generationmake/CyphalHMIBase-CAN/README.md

# CyphalHMIBase-CAN
HMI Board for the Raspberry Pi Pico with a display and some knobs to connect via CAN using OpenCyphal and UCANPHY Micro
