generationmake/CyphalHMIBase-CAN/kicad_source/CyphalHMIBase-CAN.kicad_pcb

## KiCad design kicad_source/CyphalHMIBase-CAN.kicad_pcb (2026-06-08)

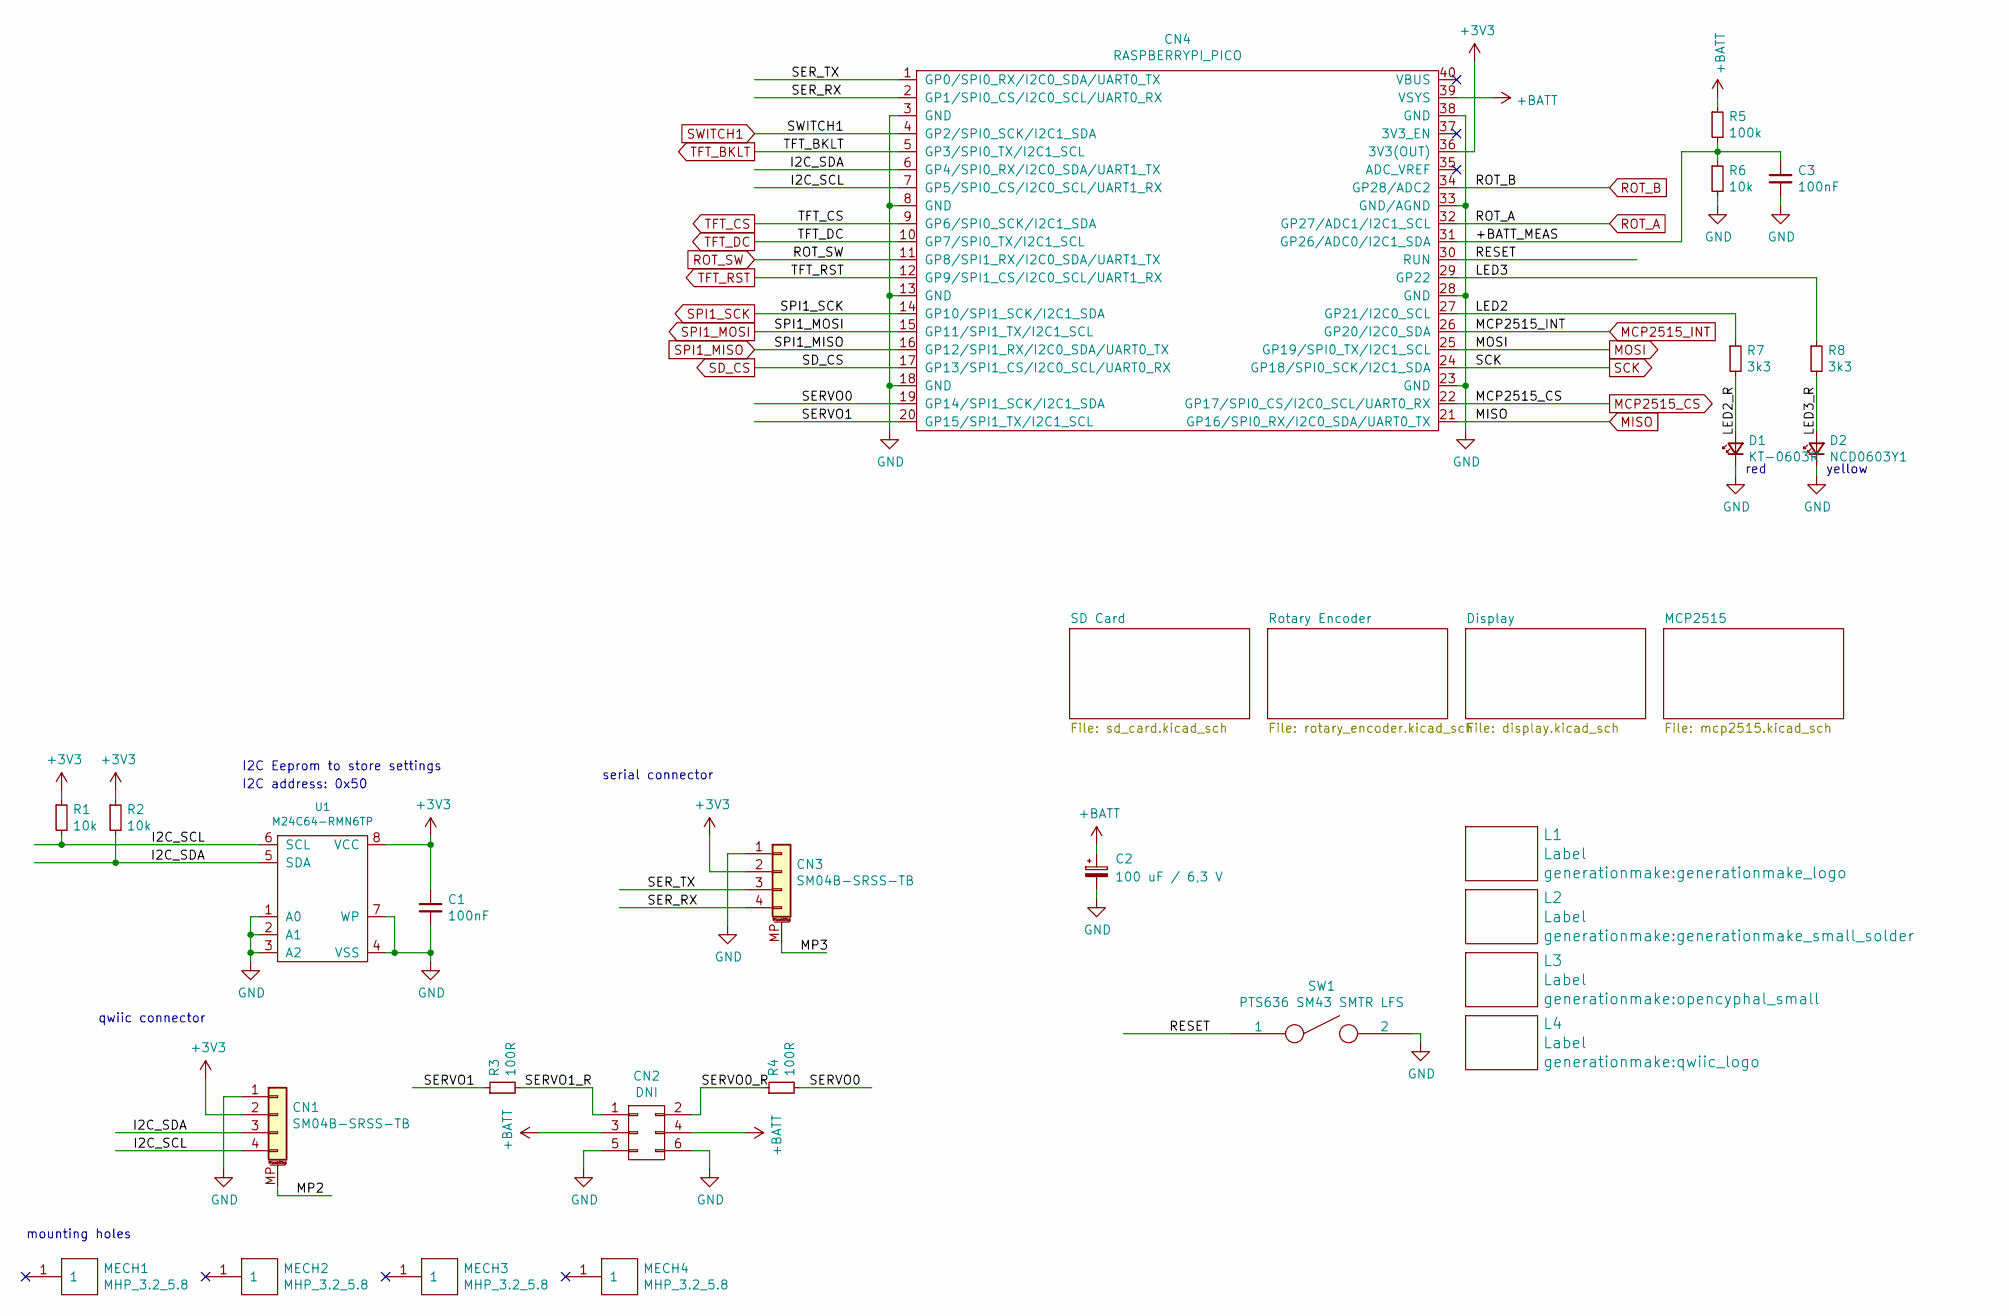
[picture p6: schematic CyphalHMIBase-CAN.kicad_sch, CyphalHMIBase/CAN]

Parts:
C1, C3: 100nF; C_0603_1608Metric; LCSC C14663
C2: 100 uF / 6,3 V; CP_Elec_5x5.3; LCSC C3001204
CN1, CN3: SM04B-SRSS-TB; JST_SH_SM04B-SRSS-TB_1x04-1MP_P1.00mm_Horizontal; LCSC C160404
CN2: DNI; PinHeader_2x03_P2.54mm_Horizontal
CN4: RASPBERRYPI_PICO; RASPI_PICO_SOLDER_ONLY
D1: KT-0603R; LED_0603_1608Metric; LCSC C2286
D2: NCD0603Y1; LED_0603_1608Metric; LCSC C84268
L1: Label; generationmake_logo
L2: Label; generationmake_small_solder
L3: Label; opencyphal_small
L4: Label; qwiic_logo
MECH1, MECH2, MECH3, MECH4: MHP_3.2_5.8
R1, R2, R6: 10k; R_0603_1608Metric; LCSC C25804
R3, R4: 100R; R_0603_1608Metric; LCSC C22775
R5: 100k; R_0603_1608Metric; LCSC C25803
R7, R8: 3k3; R_0603_1608Metric; LCSC C22978
SW1: PTS636 SM43 SMTR LFS; SW_SPST_CK_RS282G05A3; LCSC C2800965
U1: M24C64-RMN6TP; SOIC-8_3.9x4.9mm_P1.27mm; LCSC C79988

Connections:
+3V3: C1.1, CN1.2, CN3.2, CN4.36 (3V3(OUT)), R1.1, R2.1, U1.8 (VCC); also elsewhere on the board
+BATT: C2.1, CN2.3, CN2.4, CN4.39 (VSYS), R5.1; also elsewhere on the board
/+BATT_MEAS: C3.1, CN4.31 (GP26/ADC0/I2C1_SDA), R5.2, R6.1
/I2C_SCL: CN1.4, CN4.7 (GP5/SPI0_CS/I2C0_SCL/UART1_RX), R1.2, U1.6 (SCL)
/I2C_SDA: CN1.3, CN4.6 (GP4/SPI0_RX/I2C0_SDA/UART1_TX), R2.2, U1.5 (SDA)
/LED2: CN4.27 (GP21/I2C0_SCL), R7.1
/LED2_R: D1.2 (A), R7.2
/LED3: CN4.29 (GP22), R8.1
/LED3_R: D2.2 (A), R8.2
/MP2: CN1.MP (MountPin)
/MP3: CN3.MP (MountPin)
/RESET: CN4.30 (RUN), SW1.1
/SERVO0: CN4.19 (GP14/SPI1_SCK/I2C1_SDA), R4.2
/SERVO0_R: CN2.2, R4.1
/SERVO1: CN4.20 (GP15/SPI1_TX/I2C1_SCL), R3.1
/SERVO1_R: CN2.1, R3.2
/SER_RX: CN3.4, CN4.2 (GP1/SPI0_CS/I2C0_SCL/UART0_RX)
/SER_TX: CN3.3, CN4.1 (GP0/SPI0_RX/I2C0_SDA/UART0_TX)
GND: C1.2, C2.2, C3.2, CN1.1, CN2.5, CN2.6, CN3.1, CN4.3 (GND), CN4.8 (GND), CN4.13 (GND), CN4.18 (GND), CN4.23 (GND), CN4.28 (GND), CN4.33 (GND/AGND), CN4.38 (GND), D1.1 (K), D2.1 (K), R6.2, SW1.2, U1.1 (A0), U1.2 (A1), U1.3 (A2), U1.4 (VSS), U1.7 (WP); also elsewhere on the board
MCP2515_CS: CN4.22 (GP17/SPI0_CS/I2C0_SCL/UART0_RX); also elsewhere on the board
MCP2515_INT: CN4.26 (GP20/I2C0_SDA); also elsewhere on the board
MISO: CN4.21 (GP16/SPI0_RX/I2C0_SDA/UART0_TX); also elsewhere on the board
MOSI: CN4.25 (GP19/SPI0_TX/I2C1_SCL); also elsewhere on the board
ROT_A: CN4.32 (GP27/ADC1/I2C1_SCL); also elsewhere on the board
ROT_B: CN4.34 (GP28/ADC2); also elsewhere on the board
ROT_SW: CN4.11 (GP8/SPI1_RX/I2C0_SDA/UART1_TX); also elsewhere on the board
SCK: CN4.24 (GP18/SPI0_SCK/I2C1_SDA); also elsewhere on the board
SD_CS: CN4.17 (GP13/SPI1_CS/I2C0_SCL/UART0_RX); also elsewhere on the board
SPI1_MISO: CN4.16 (GP12/SPI1_RX/I2C0_SDA/UART0_TX); also elsewhere on the board
SPI1_MOSI: CN4.15 (GP11/SPI1_TX/I2C1_SCL); also elsewhere on the board
SPI1_SCK: CN4.14 (GP10/SPI1_SCK/I2C1_SDA); also elsewhere on the board
SWITCH1: CN4.4 (GP2/SPI0_SCK/I2C1_SDA); also elsewhere on the board
TFT_BKLT: CN4.5 (GP3/SPI0_TX/I2C1_SCL); also elsewhere on the board
TFT_CS: CN4.9 (GP6/SPI0_SCK/I2C1_SDA); also elsewhere on the board
TFT_DC: CN4.10 (GP7/SPI0_TX/I2C1_SCL); also elsewhere on the board
TFT_RST: CN4.12 (GP9/SPI1_CS/I2C0_SCL/UART1_RX); also elsewhere on the board

Notes on the sheet:
yellow
serial connector
qwiic connector
mounting holes
red
I2C address: 0x50
I2C Eeprom to store settings

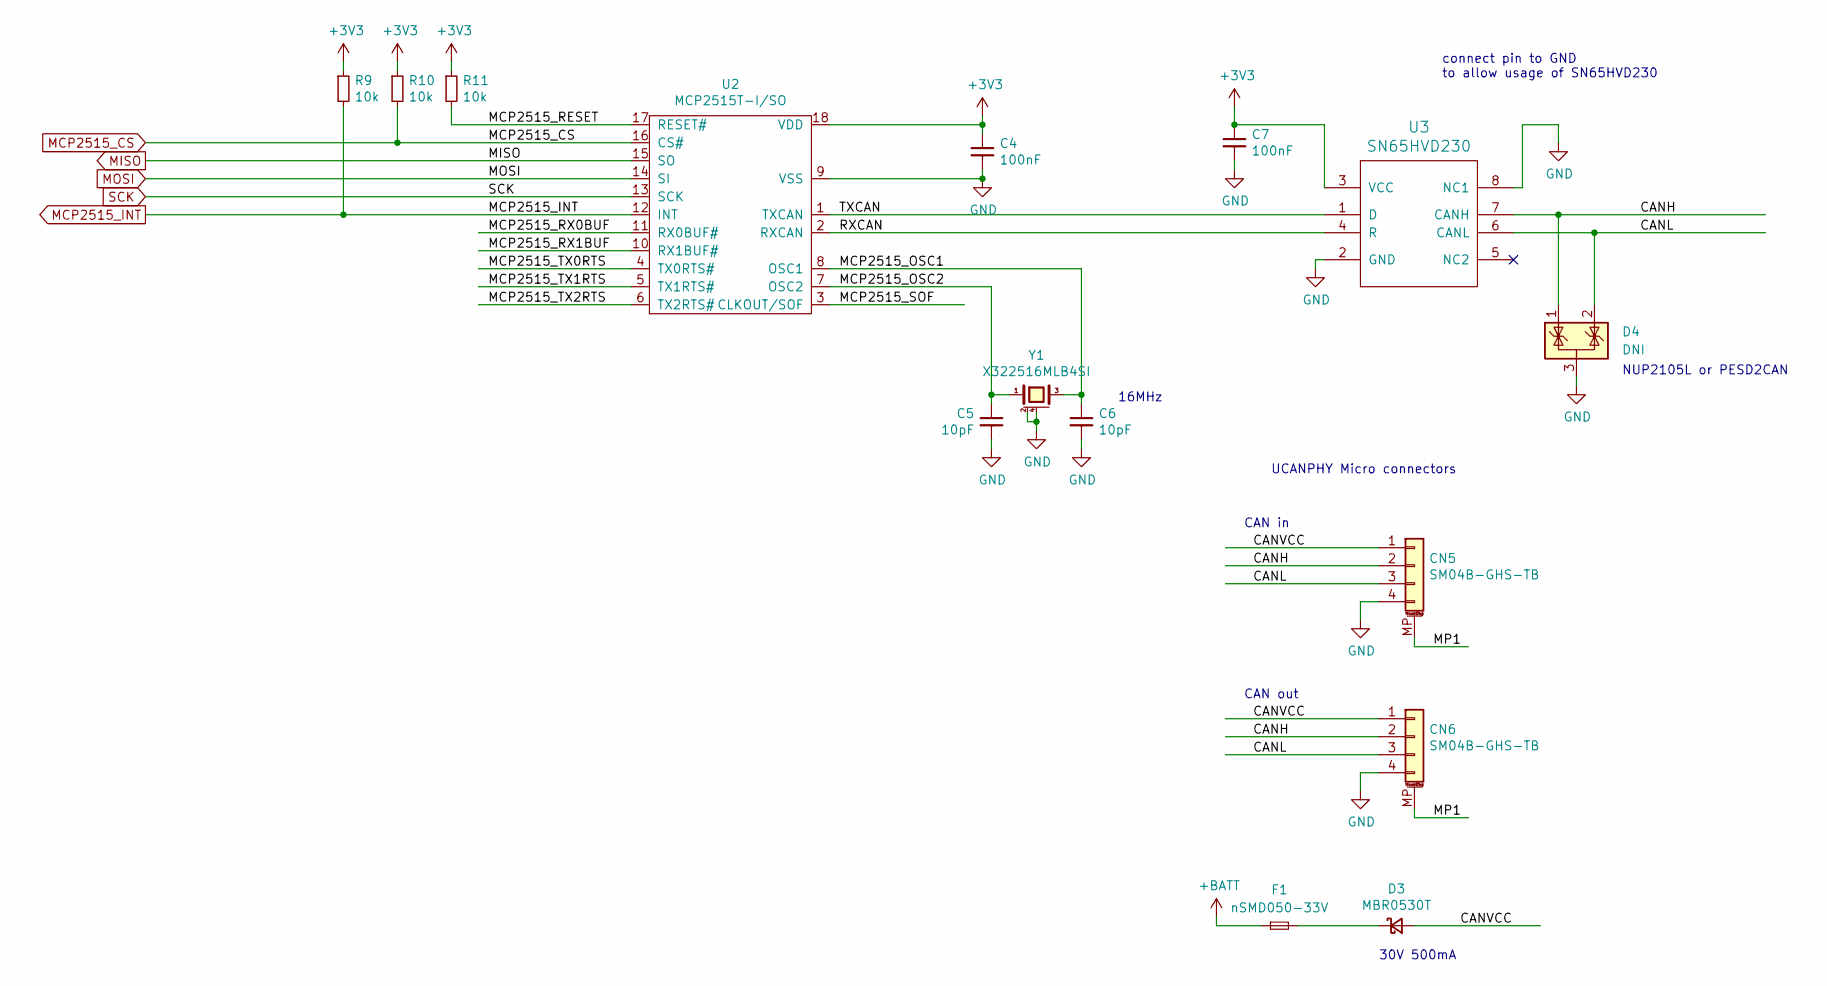
[picture p7: schematic mcp2515.kicad_sch, CyphalHMIBase/CAN]

Parts:
C4, C7: 100nF; C_0603_1608Metric; LCSC C14663
C5, C6: 10pF; C_0603_1608Metric; LCSC C1634
CN5, CN6: SM04B-GHS-TB; JST_GH_SM04B-GHS-TB_1x04-1MP_P1.25mm_Horizontal; LCSC C189895
D3: MBR0530T; D_SOD-123; LCSC C77336
D4: DNI; SOT-23
F1: nSMD050-33V; Fuse_1206_3216Metric; LCSC C70077
R9, R10, R11: 10k; R_0603_1608Metric; LCSC C25804
U2: MCP2515T-I/SO; SOIC-18W_7.5x11.6mm_P1.27mm; LCSC C153782
U3: SN65HVD230; SOIC-8_3.9x4.9mm_P1.27mm; LCSC C12084
Y1: X322516MLB4SI; Crystal_SMD_3.2x2.5mm_4Pad; LCSC C13738

Connections:
+3V3: C4.1, C7.1, R9.1, R10.1, R11.1, U2.18 (VDD), U3.3 (VCC); also elsewhere on the board
+BATT: F1.1; also elsewhere on the board
/MCP2515/CANH: CN5.2, CN6.2, D4.1 (K), U3.7 (CANH)
/MCP2515/CANL: CN5.3, CN6.3, D4.2 (K), U3.6 (CANL)
/MCP2515/CANVCC: CN5.1, CN6.1, D3.2 (A)
/MCP2515/MCP2515_OSC1: C6.1, U2.8 (OSC1), Y1.3
/MCP2515/MCP2515_OSC2: C5.1, U2.7 (OSC2), Y1.1
/MCP2515/MCP2515_RESET: R11.2, U2.17 (RESET#)
/MCP2515/MCP2515_RX0BUF: U2.11 (RX0BUF#)
/MCP2515/MCP2515_RX1BUF: U2.10 (RX1BUF#)
/MCP2515/MCP2515_SOF: U2.3 (CLKOUT/SOF)
/MCP2515/MCP2515_TX0RTS: U2.4 (TX0RTS#)
/MCP2515/MCP2515_TX1RTS: U2.5 (TX1RTS#)
/MCP2515/MCP2515_TX2RTS: U2.6 (TX2RTS#)
/MCP2515/MP1: CN5.MP (MountPin), CN6.MP (MountPin)
/MCP2515/RXCAN: U2.2 (RXCAN), U3.4 (R)
/MCP2515/TXCAN: U2.1 (TXCAN), U3.1 (D)
GND: C4.2, C5.2, C6.2, C7.2, CN5.4, CN6.4, D4.3 (A), U2.9 (VSS), U3.2 (GND), U3.8 (NC1), Y1.2 (case), Y1.4 (case); also elsewhere on the board
MCP2515_CS: R10.2, U2.16 (CS#); also elsewhere on the board
MCP2515_INT: R9.2, U2.12 (INT); also elsewhere on the board
MISO: U2.15 (SO); also elsewhere on the board
MOSI: U2.14 (SI); also elsewhere on the board
unnamed: D3.1 (K), F1.2
SCK: U2.13 (SCK); also elsewhere on the board

Notes on the sheet:
16MHz
NUP2105L or PESD2CAN
connect pin to GND to allow usage of SN65HVD230
UCANPHY Micro connectors
30V 500mA
CAN in
CAN out

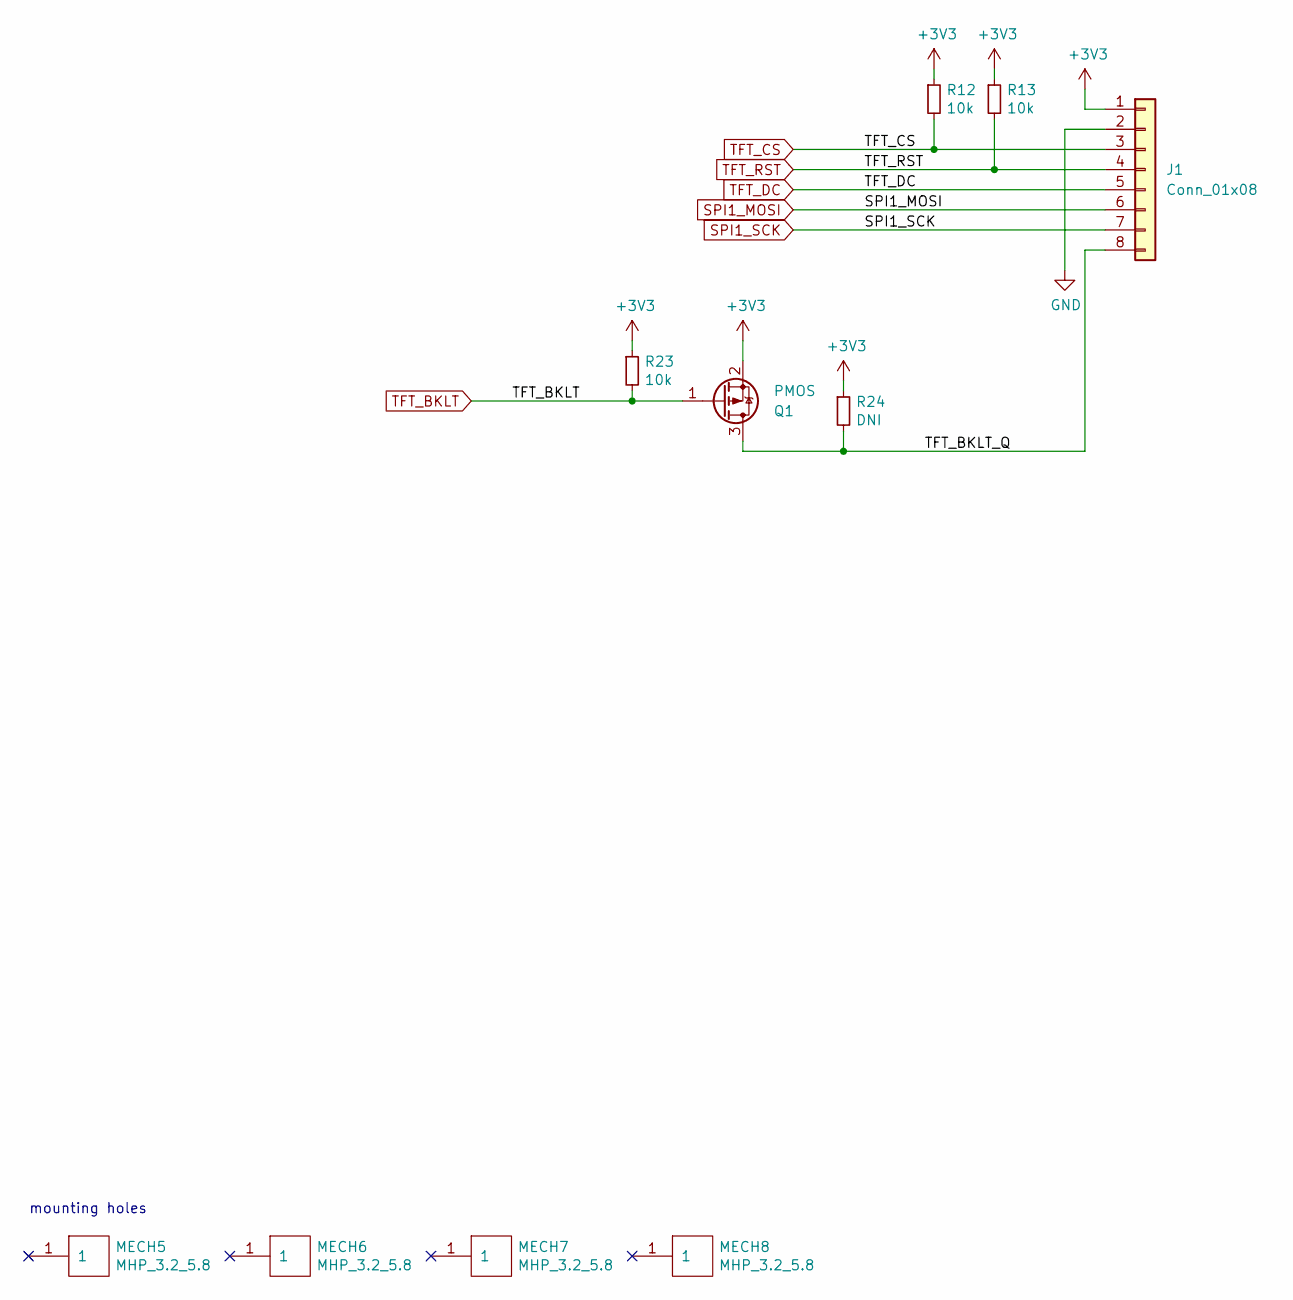
[picture p8: schematic display.kicad_sch, CyphalHMIBase/CAN]

Parts:
J1: Conn_01x08; PinHeader_1x08_P2.54mm_Vertical
MECH5, MECH6, MECH7, MECH8: MHP_3.2_5.8; MountingHole_3.2mm_M3_ISO14580_Pad
Q1: PMOS; SOT-23
R12, R13, R23: 10k; R_0603_1608Metric; LCSC C25804
R24: DNI; R_0603_1608Metric; LCSC C25804

Connections:
+3V3: J1.1, Q1.2 (S), R12.1, R13.1, R23.1, R24.1; also elsewhere on the board
/Display/TFT_BKLT_Q: J1.8, Q1.3 (D), R24.2
GND: J1.2; also elsewhere on the board
SPI1_MOSI: J1.6; also elsewhere on the board
SPI1_SCK: J1.7; also elsewhere on the board
TFT_BKLT: Q1.1 (G), R23.2; also elsewhere on the board
TFT_CS: J1.3, R12.2; also elsewhere on the board
TFT_DC: J1.5; also elsewhere on the board
TFT_RST: J1.4, R13.2; also elsewhere on the board

Notes on the sheet:
mounting holes

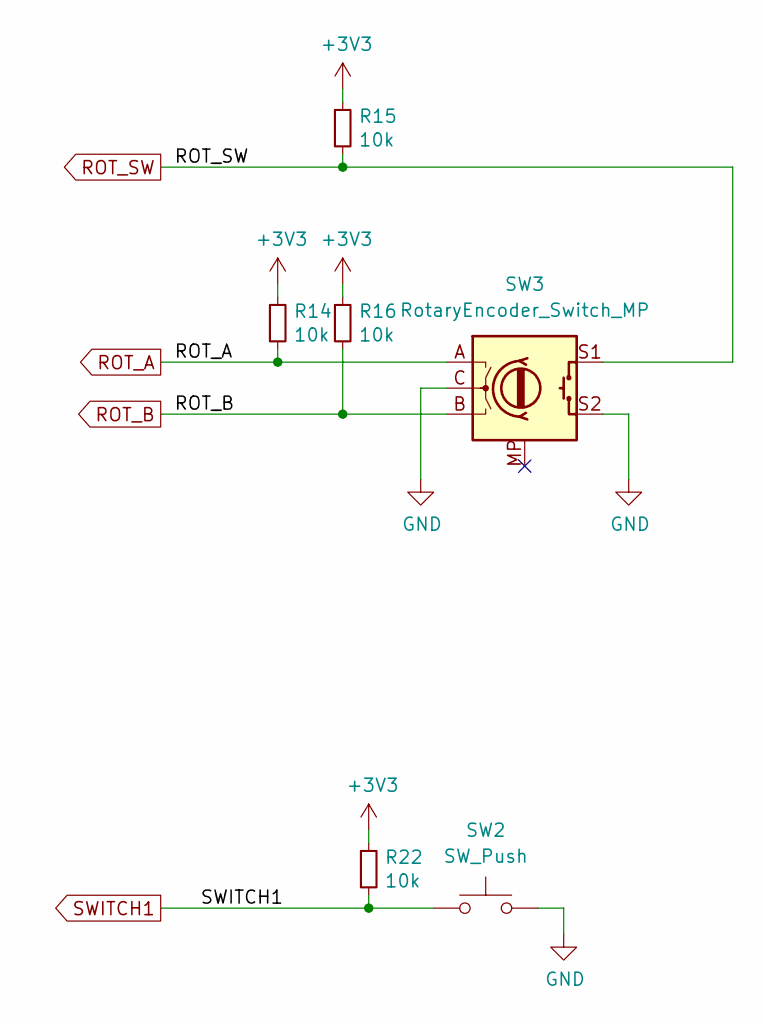
[picture p9: schematic rotary_encoder.kicad_sch, CyphalHMIBase/CAN]

Parts:
R14, R15, R16, R22: 10k; R_0603_1608Metric; LCSC C25804
SW2: SW_Push; SW_SPST_Omron_B3FS-100xP
SW3: RotaryEncoder_Switch_MP; RotaryEncoder_Alps_EC11E-Switch_Vertical_H20mm_CircularMoun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

Connections:
+3V3: R14.1, R15.1, R16.1, R22.1; also elsewhere on the board
GND: SW2.2, SW3.C, SW3.S2; also elsewhere on the board
ROT_A: R14.2, SW3.A; also elsewhere on the board
ROT_B: R16.2, SW3.B; also elsewhere on the board
ROT_SW: R15.2, SW3.S1; also elsewhere on the board
SWITCH1: R22.2, SW2.1; also elsewhere on the board

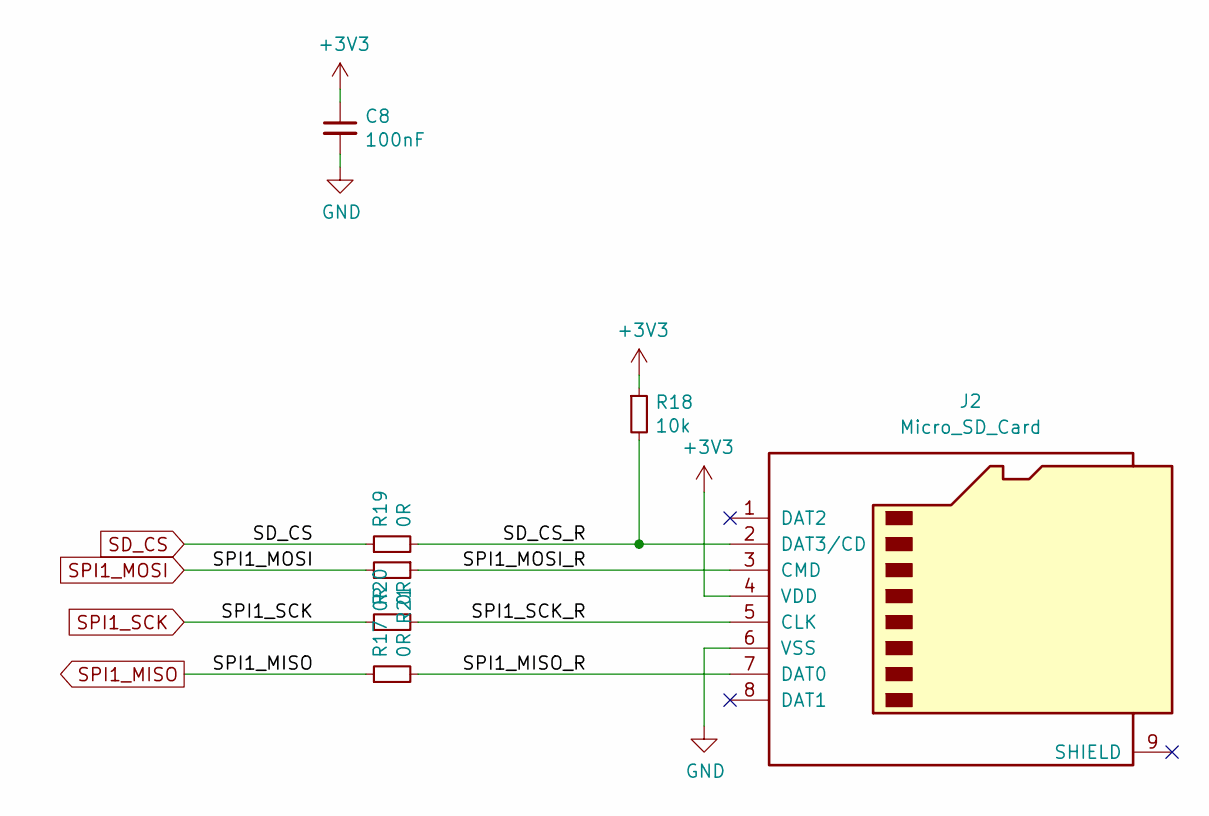
[picture p10: schematic sd_card.kicad_sch, CyphalHMIBase/CAN]

Parts:
C8: 100nF; C_0603_1608Metric; LCSC C14663
J2: Micro_SD_Card; WE_693071010811
R17, R19, R20, R21: 0R; R_0603_1608Metric; LCSC C22775
R18: 10k; R_0603_1608Metric; LCSC C25804

Connections:
+3V3: C8.1, J2.4 (VDD), R18.1; also elsewhere on the board
/SD Card/SD_CS_R: J2.2 (DAT3/CD), R18.2, R19.2
/SD Card/SPI1_MISO_R: J2.7 (DAT0), R17.2
/SD Card/SPI1_MOSI_R: J2.3 (CMD), R21.1
/SD Card/SPI1_SCK_R: J2.5 (CLK), R20.2
GND: C8.2, J2.6 (VSS); also elsewhere on the board
SD_CS: R19.1; also elsewhere on the board
SPI1_MISO: R17.1; also elsewhere on the board
SPI1_MOSI: R21.2; also elsewhere on the board
SPI1_SCK: R20.1; also elsewhere on the board

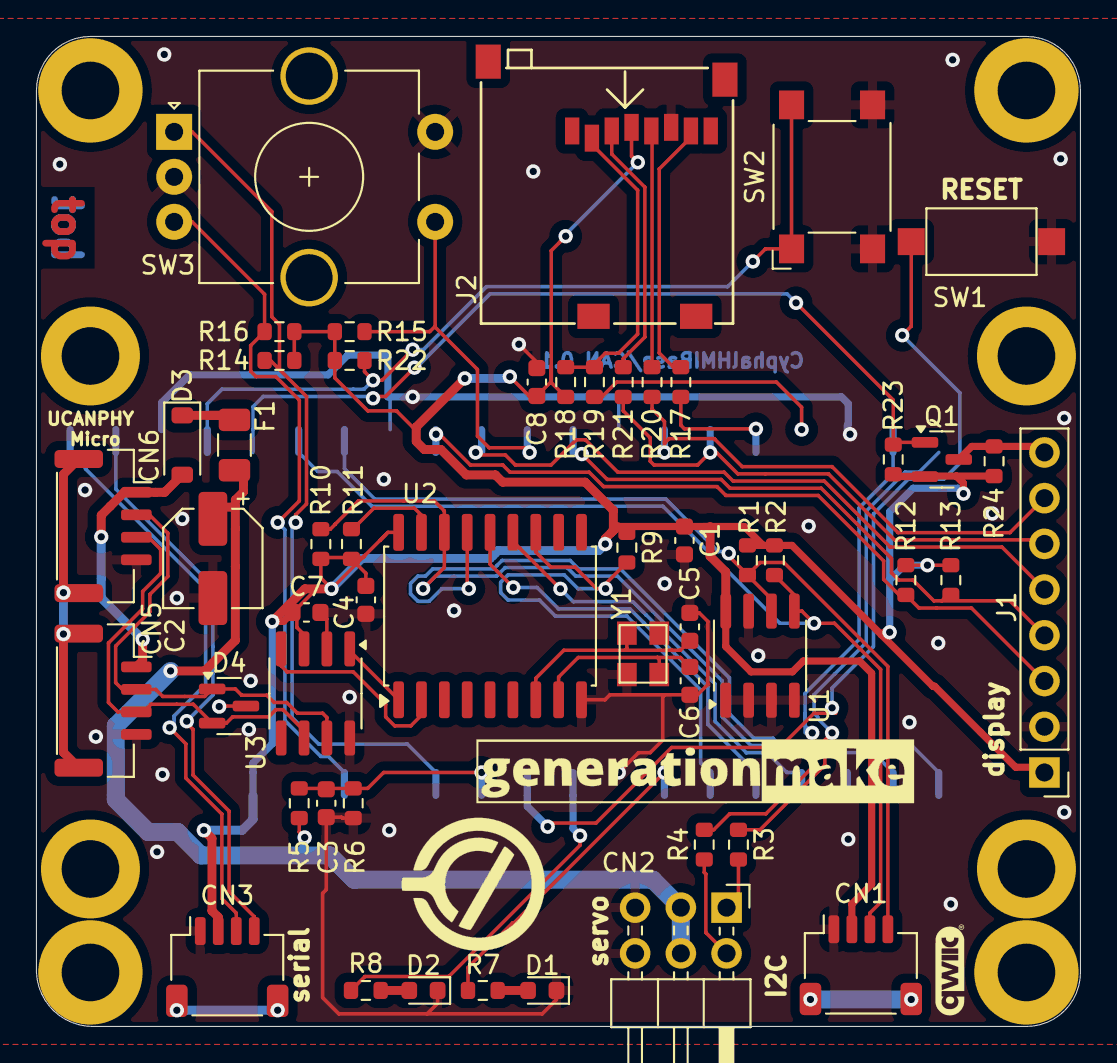
[picture p11: board CyphalHMIBase-CAN.kicad_pcb from above]

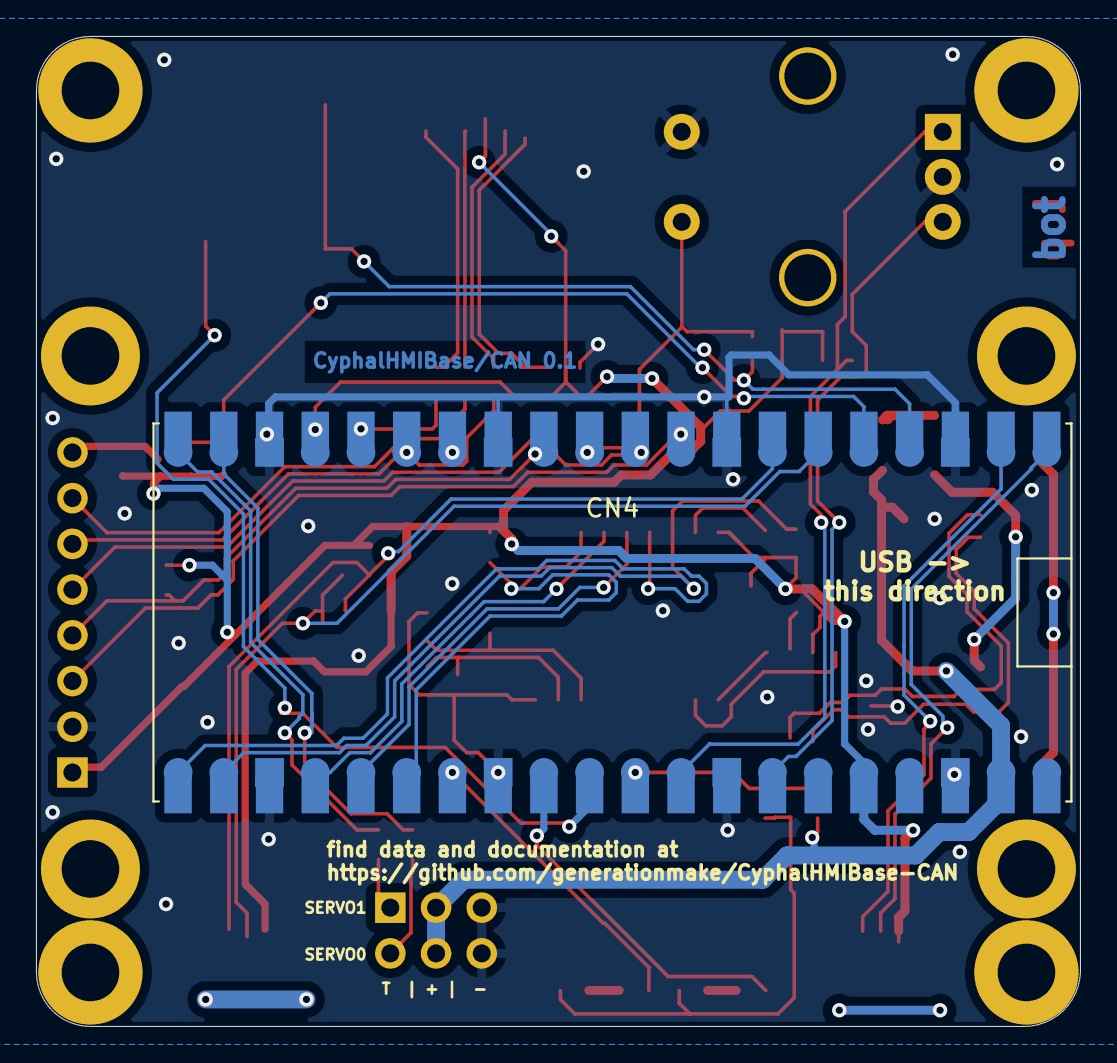
[picture p12: board CyphalHMIBase-CAN.kicad_pcb from below]

Board: 2 copper layers, 58.0 x 55.0 mm, 65 parts (2 on the bottom side), 49 nets.
