generationmake/CyphalHMIBase-CAN/(commit log)

2026-06-03 copied files from CyphalPicoBase/CAN
    [CyphalHMIBase-CAN.kicad_pcb, CyphalHMIBase-CAN.kicad_sch, mcp2515.kicad_sch]
2026-06-03 removed unnecessary parts
    [CyphalHMIBase-CAN.kicad_pcb, CyphalHMIBase-CAN.kicad_sch, mcp2515.kicad_sch]
2026-06-03 added display
    [CyphalHMIBase-CAN.kicad_pcb, CyphalHMIBase-CAN.kicad_sch, mcp2515.kicad_sch]
2026-06-03 added display schematic page
    [display.kicad_sch]
2026-06-04 added encoder, mounting holes for display at correct position
    [CyphalHMIBase-CAN.kicad_pcb, CyphalHMIBase-CAN.kicad_sch, display.kicad_sch, mcp2515.kicad_sch, rotary_encoder.kicad_sch]
2026-06-05 added sd card, updated layout
    [CyphalHMIBase-CAN.kicad_pcb, CyphalHMIBase-CAN.kicad_sch, mcp2515.kicad_sch, rotary_encoder.kicad_sch, sd_card.kicad_sch]
2026-06-05 added push button
    [CyphalHMIBase-CAN.kicad_pcb, CyphalHMIBase-CAN.kicad_sch, display.kicad_sch, mcp2515.kicad_sch, rotary_encoder.kicad_sch, sd_card.kicad_sch]
2026-06-05 added backlight control
    [CyphalHMIBase-CAN.kicad_pcb, CyphalHMIBase-CAN.kicad_sch, display.kicad_sch]
2026-06-05 added schematic pdf
2026-06-06 fixed drc errors
    [CyphalHMIBase-CAN.kicad_pcb, CyphalHMIBase-CAN.kicad_sch, display.kicad_sch, mcp2515.kicad_sch, rotary_encoder.kicad_sch, sd_card.kicad_sch]
2026-06-08 fixed micro sd card connector
    [CyphalHMIBase-CAN.kicad_pcb, CyphalHMIBase-CAN.kicad_sch, display.kicad_sch, mcp2515.kicad_sch, rotary_encoder.kicad_sch, sd_card.kicad_sch]
